adamalfath/sentsor-uno-plus/media/OSHW_mark_ID000006.png

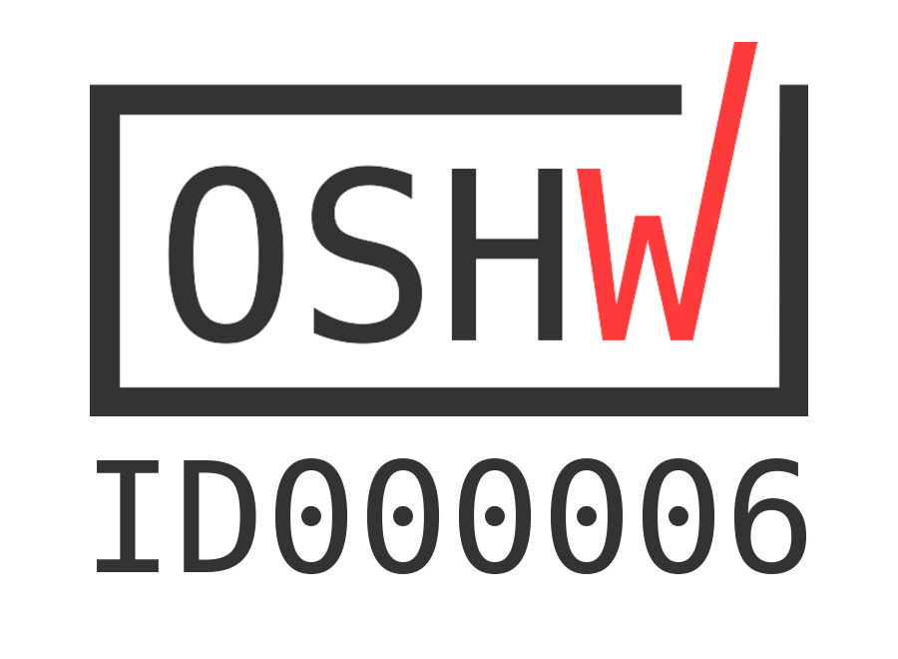
media/OSHW_mark_ID000006.png
