adamalfath/sentsor-uno-plus/media/sq/unoplus-img0sq.jpg

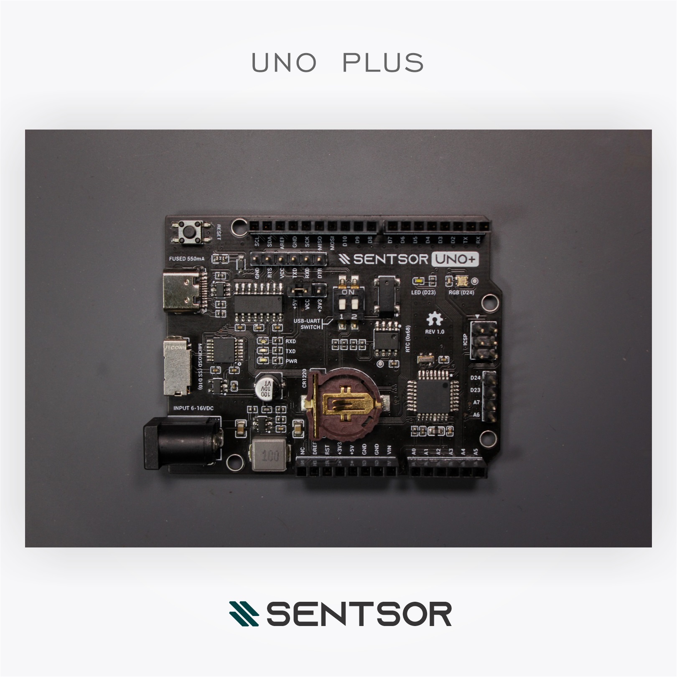
media/sq/unoplus-img0sq.jpg
