adamalfath/sentsor-uno-plus/media/sq/unoplus-img1sq.jpg

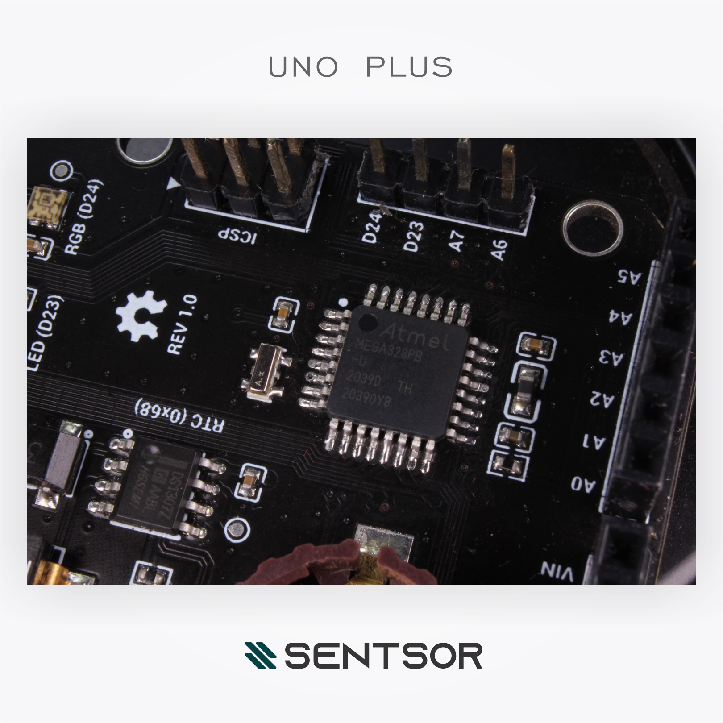
media/sq/unoplus-img1sq.jpg
