adamalfath/sentsor-uno-plus/media/sq/unoplus-img2sq.jpg

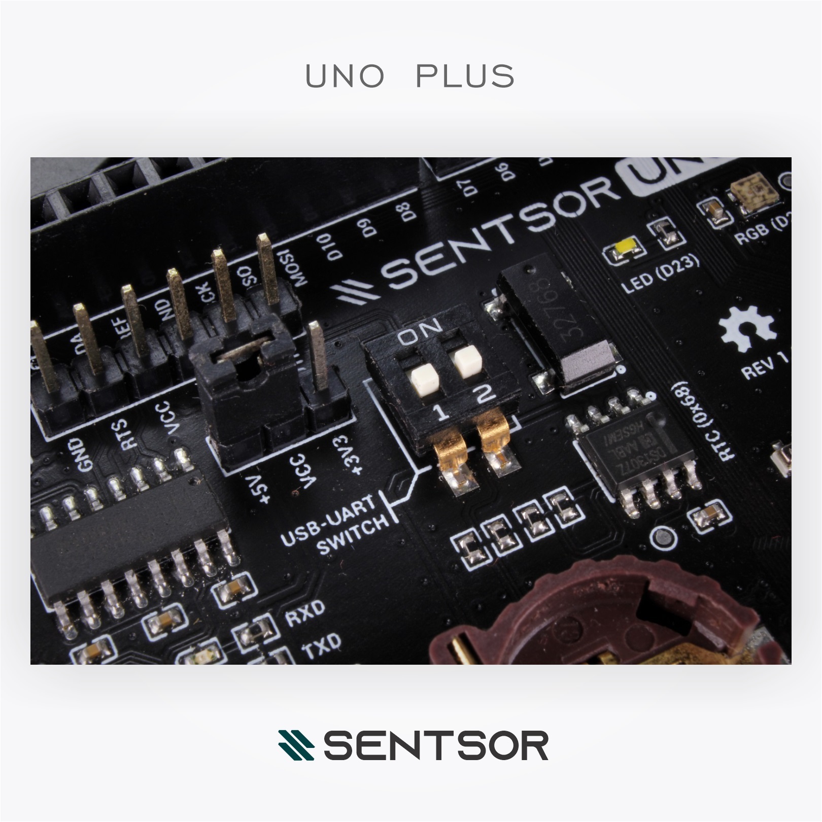
media/sq/unoplus-img2sq.jpg
