adamalfath/sentsor-uno-plus/media/sq/unoplus-img3sq.jpg

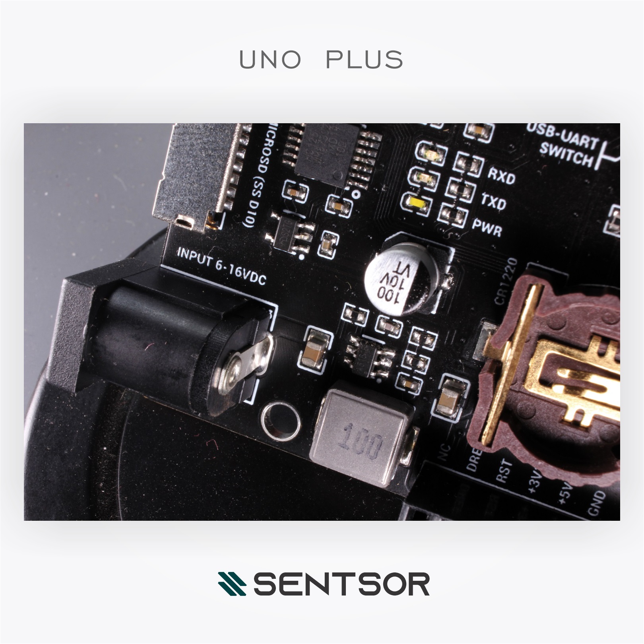
media/sq/unoplus-img3sq.jpg
