adamalfath/sentsor-uno-plus/media/sq/unoplus-img4sq.jpg

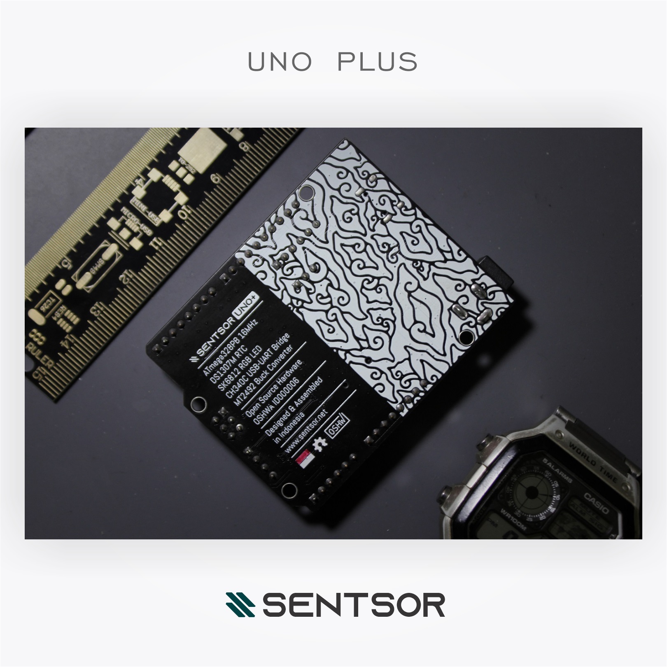
media/sq/unoplus-img4sq.jpg
