adamalfath/sentsor-uno-plus/media/unoplus-extra0.png

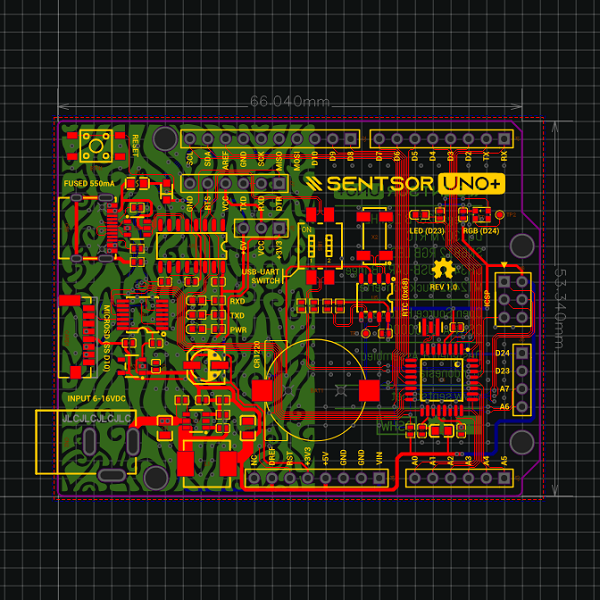
media/unoplus-extra0.png
