adamalfath/sentsor-uno-plus/media/unoplus-extra1.jpg

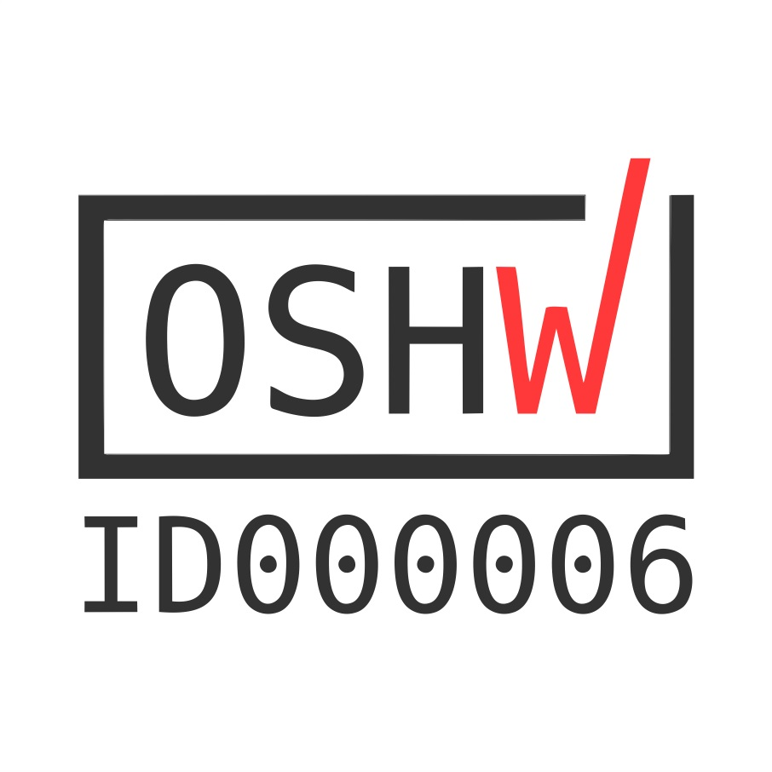
media/unoplus-extra1.jpg
