adamalfath/sentsor-uno-plus/media/unoplus-extra2.jpg

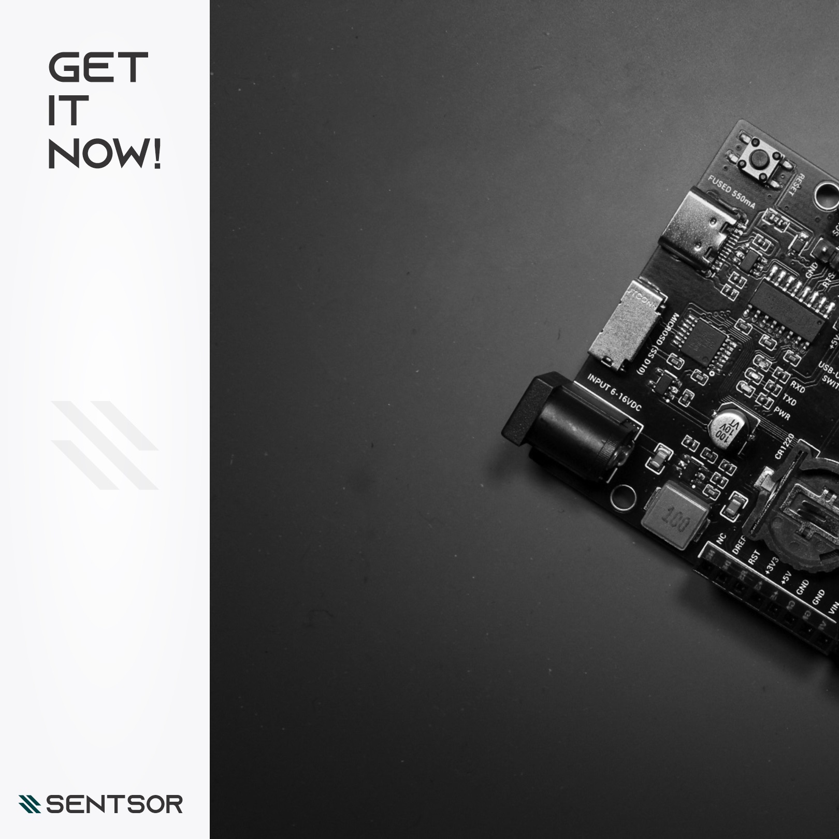
media/unoplus-extra2.jpg
