adamalfath/sentsor-uno-plus/media/unoplus-extra3.jpg

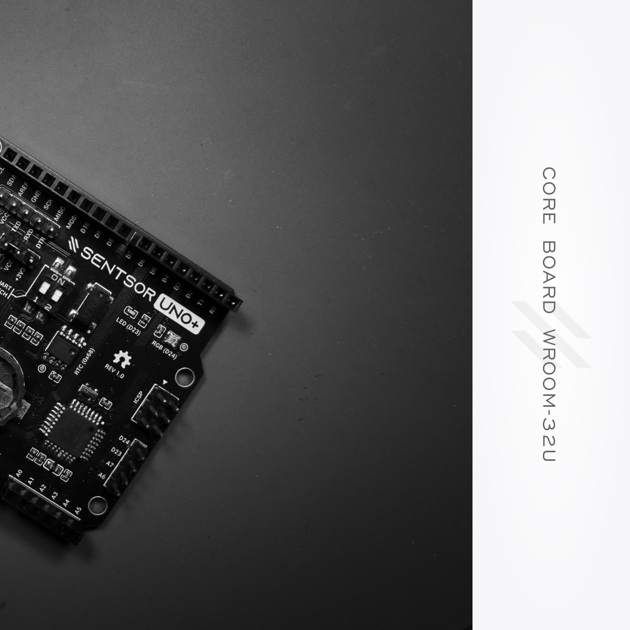
media/unoplus-extra3.jpg
