adamalfath/sentsor-uno-plus/media/unoplus-img9.jpg

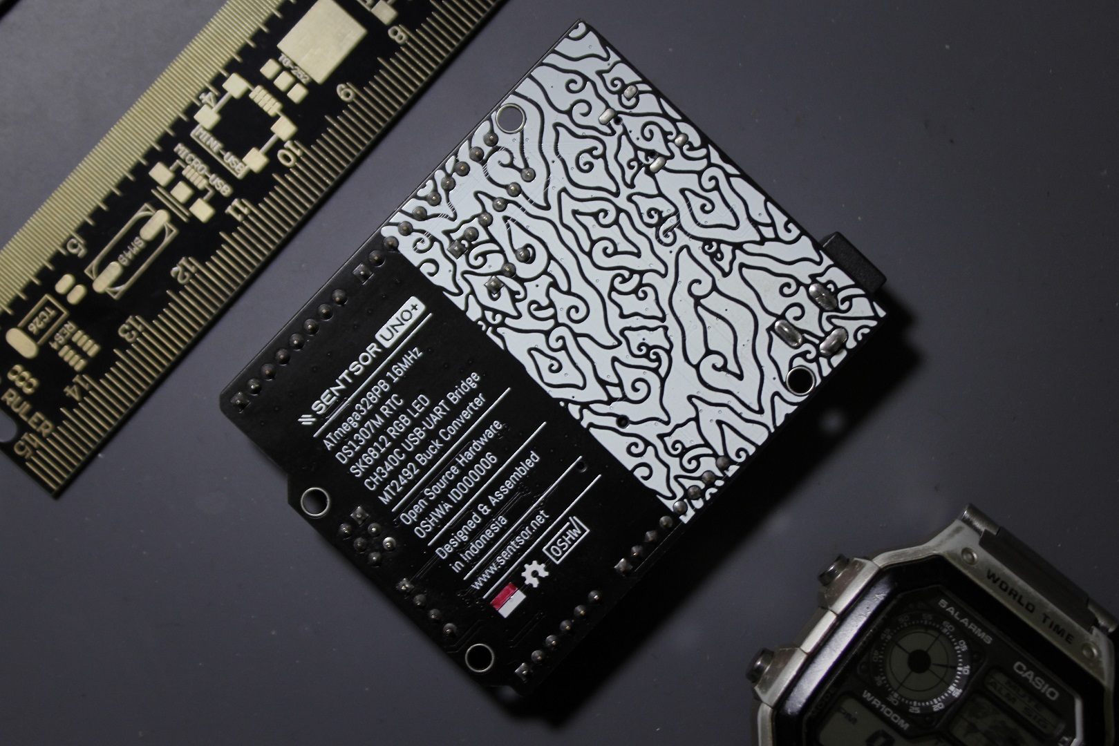
media/unoplus-img9.jpg
