adamalfath/sentsor-uno-plus/Schematic_SENTSOR UNO Plus_R1.0.pdf

A | A

1

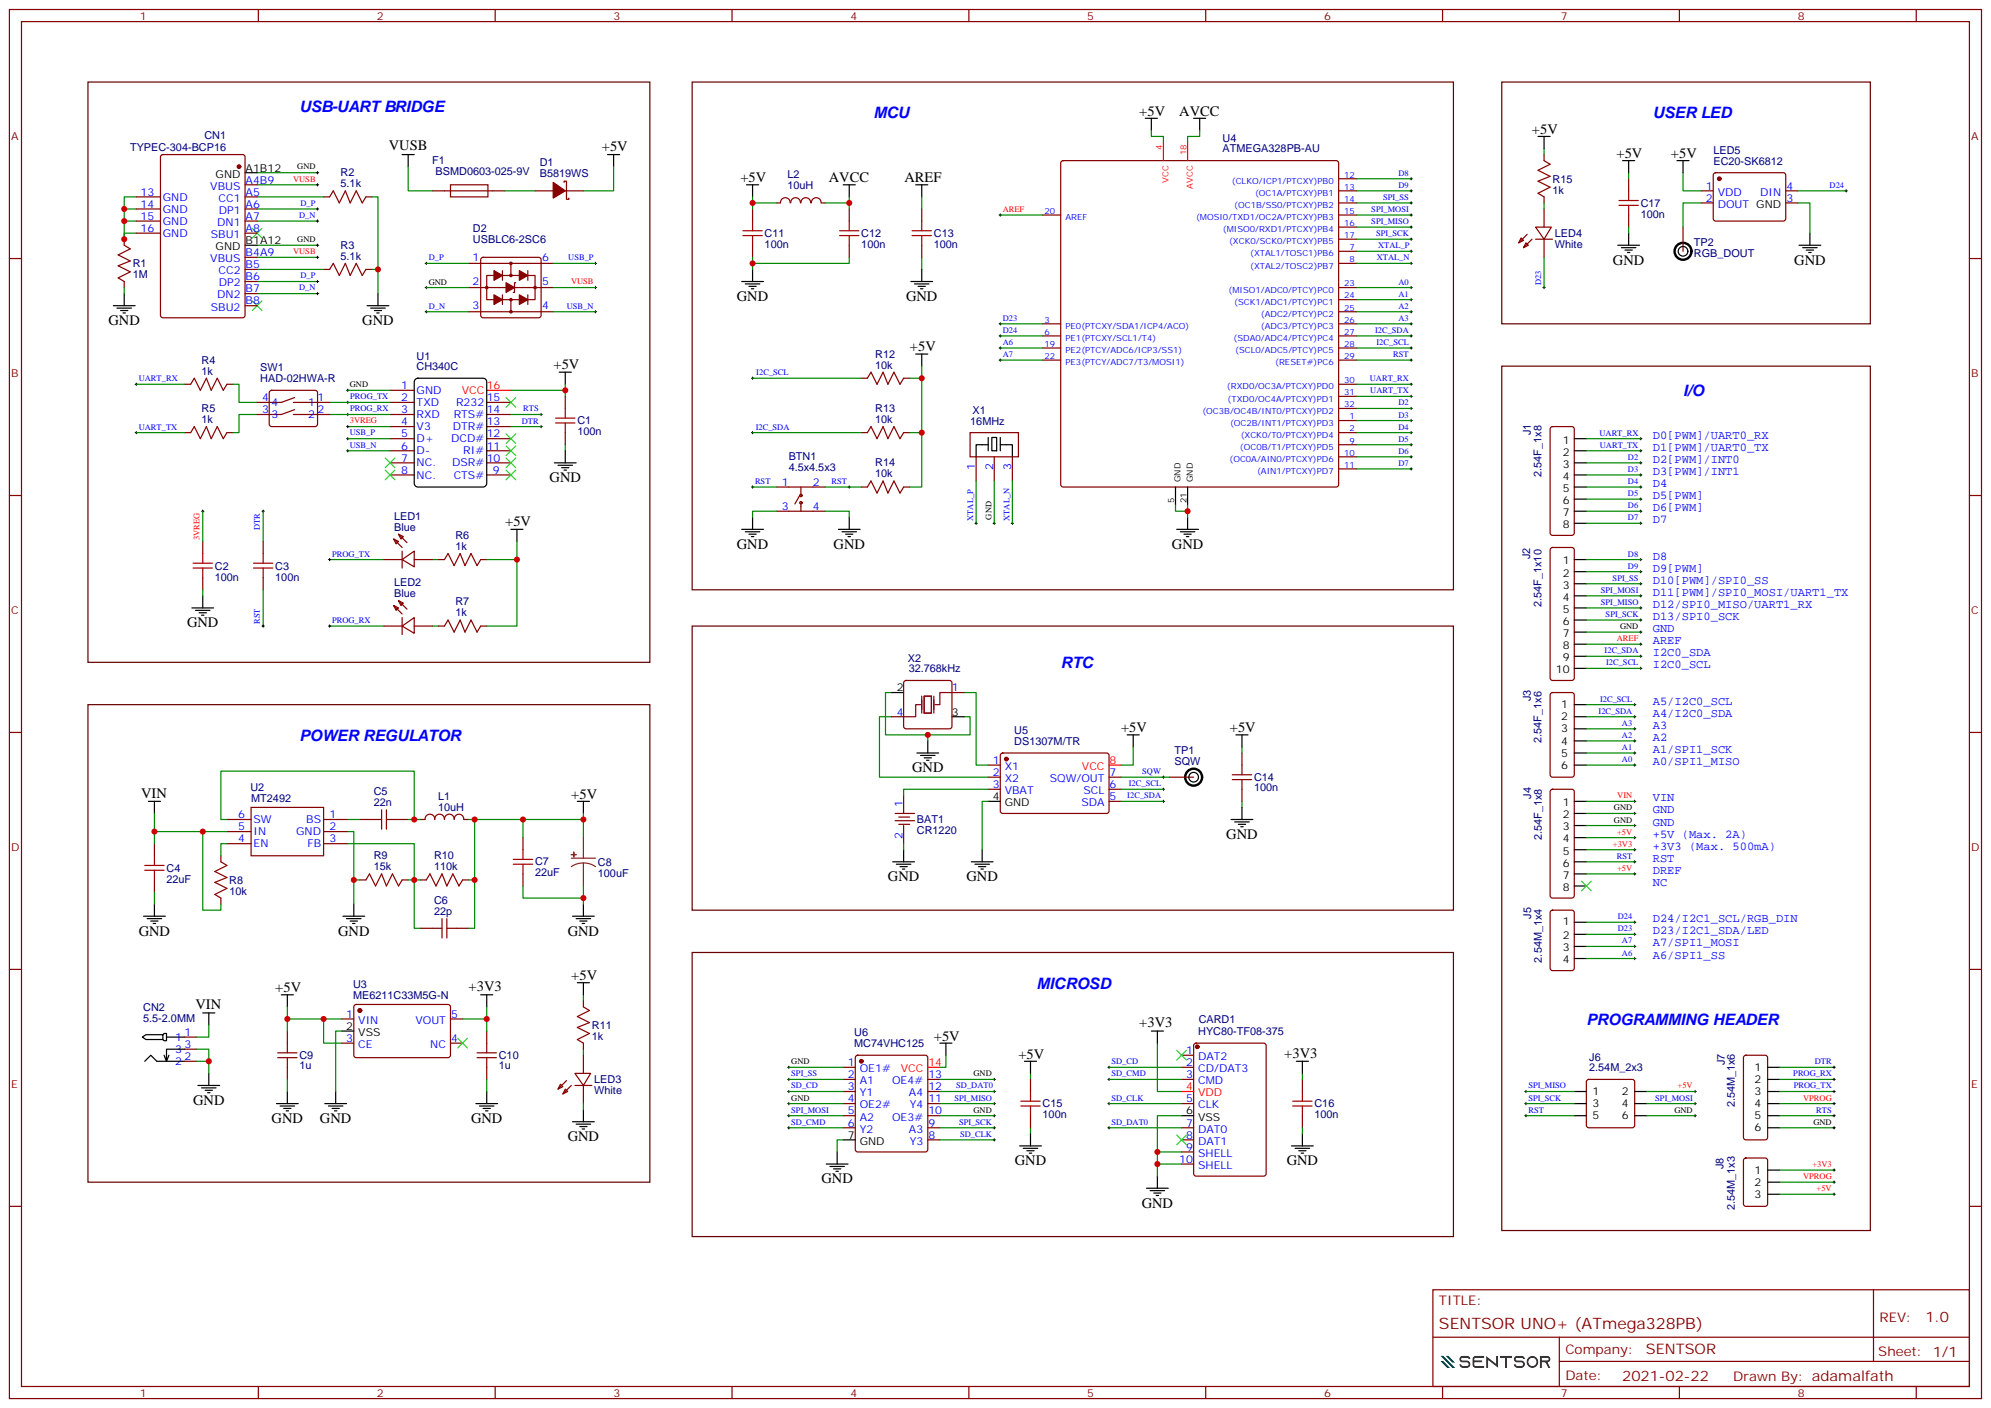
[picture p29: page 1]

USB-UART BRIDGE
SBU2 B8 DN2 B7 DP2 B6 CC2 B5 VBUS B4A9 GND B1A12 SBU1 A8 DN1 A7 DP1 A6 CC1 A5 VBUS A4B9 GND A1B12

GND 16 GND 15 GND 14 GND 13
